todbot/TrinketTouringMachine/README.md

# Trinket Touring Machine

Eurorack module based around Trinket M0

Initially started as an homage to Music Thing Modular's "Turing Machine" module, but as evolved into something more like an algorithmic melody generator.

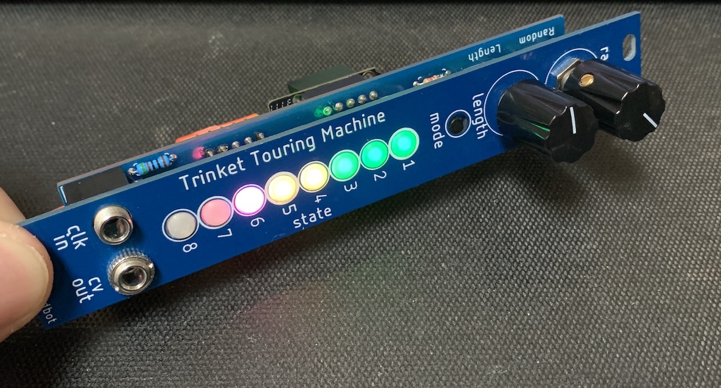
[picture p1: docs/trinkettouringmachine.jpg]
