todbot/TrinketTouringMachine/hardware/TrinketTrigger.brd

## EAGLE design hardware/TrinketTrigger.brd (2020-05-09)

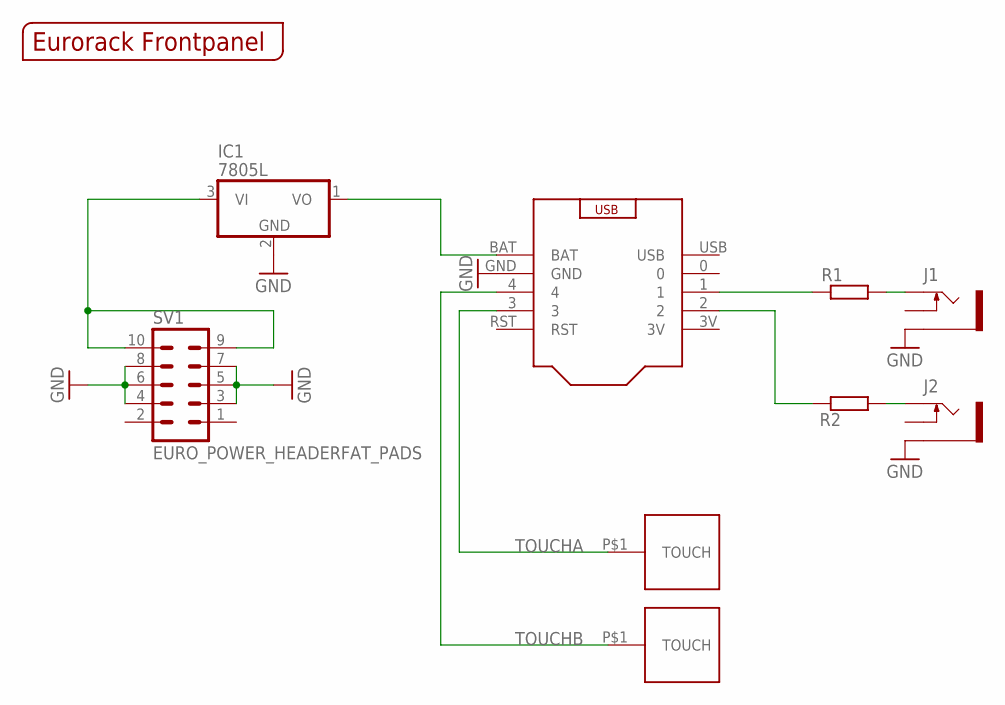
[picture p2: schematic TrinketTrigger.sch]

Parts:
IC1: 7805L; TO92
J1, J2: THONKICONNNEW; WQP-PJ301M-12_JACK
R1, R2: R-EU_0204/5; 0204/5
SV1: EURO_POWER_HEADERFAT_PADS; EURO_PWR_HEADER_FAT
U$1: EURORACK_PANEL6HP; EURORACK6HPPANEL
U$2: TRINKETM0NH; TRINKETMO_NOHOLES
U$3, U$4: TOUCHPADA

Connections:
GND: IC1.2 (GND), J1.P$3_SLEEVE (SLEEVE), J2.P$3_SLEEVE (SLEEVE), SV1.3, SV1.4, SV1.5, SV1.6, SV1.7, SV1.8, U$2.GND
unnamed: J1.P$1_TIP (TIP), R1.2
unnamed: J2.P$1_TIP (TIP), R2.2
unnamed: IC1.1 (VO), U$2.BAT
unnamed: IC1.3 (VI), SV1.9, SV1.10
unnamed: R1.1, U$2.1
unnamed: R2.1, U$2.2
TOUCHA: U$2.3, U$3.P$1
TOUCHB: U$2.4, U$4.P$1

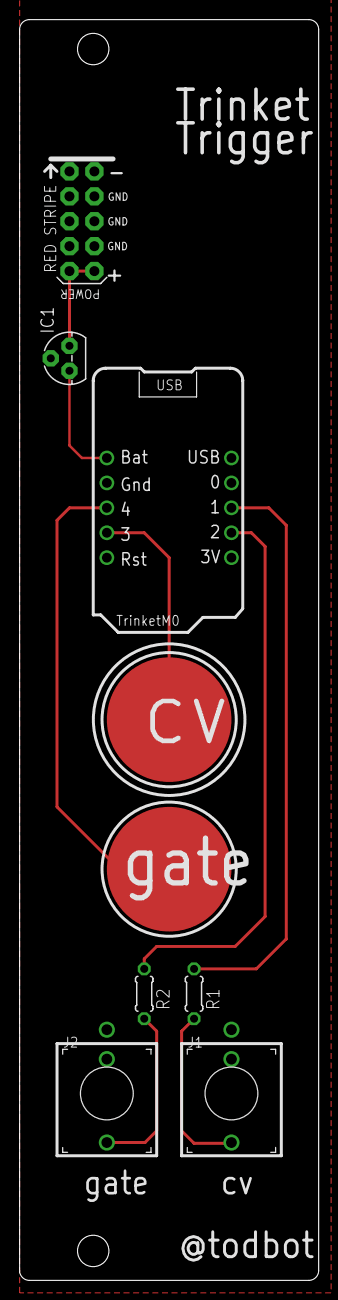
[picture p3: board TrinketTrigger.brd from above]

Board: 2 copper layers, 30.5 x 128.5 mm, 10 parts (0 on the bottom side), 9 nets.
