todbot/TrinketTouringMachine/hardware/touringmach3.brd

## EAGLE design hardware/touringmach3.brd (2019-09-17)

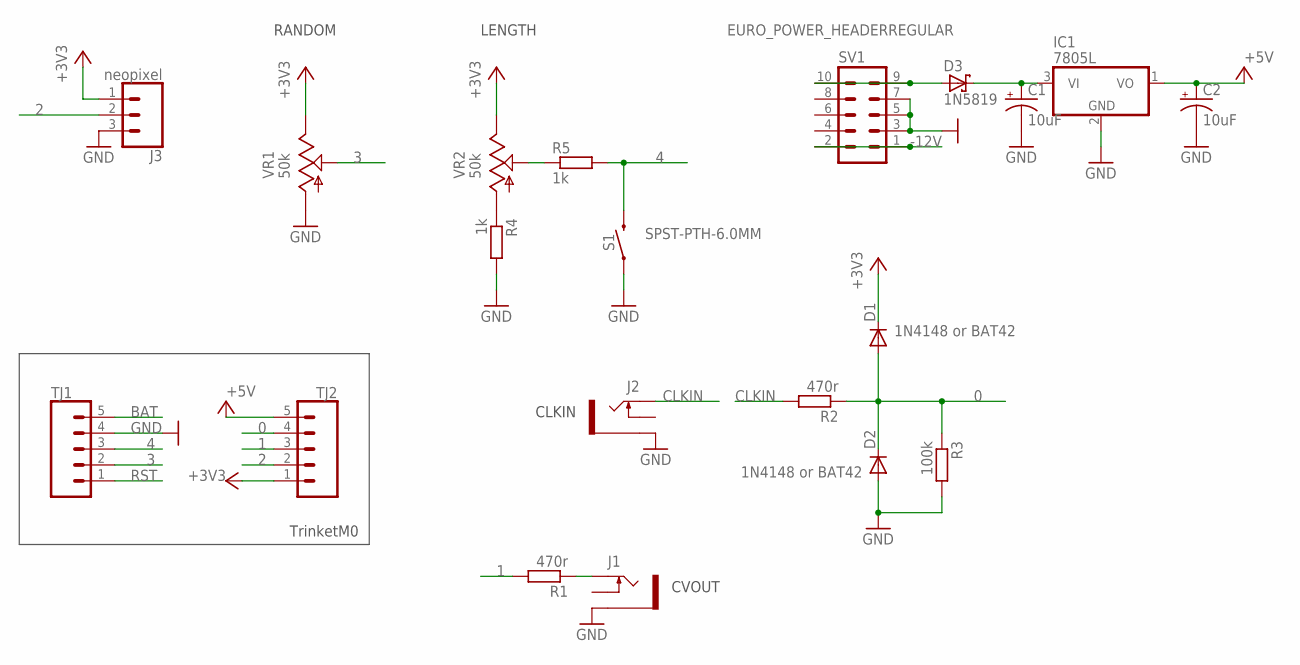
[picture p4: schematic touringmach3.sch]

Parts:
C1, C2: 10uF; E2,5-6
D1, D2: 1N4148 or BAT42; DO34-7
D3: 1N5819; DO41-7.6
IC1: 7805L; TO92
J1, J2: THONKICONNOLD; THONKICONN
J3: neopixel; 1X03
R1, R2: 470r; 7MM_RESISTOR
R3: 100k; 7MM_RESISTOR
R4, R5: 1k; 7MM_RESISTOR
S1: SPST-PTH-6.0MM; TACTILE_SWITCH_PTH_6.0MM
SV1: EURO_POWER_HEADERREGULAR; EURO_POWER_HEADER
TJ1, TJ2: CONN_05; 1X05
VR1, VR2: 50k; 9MM_SNAP-IN_POT

Connections:
0: D1.A, D2.C, R2.1, R3.1, TJ2.4
1: R1.2, TJ2.3
2: J3.2, TJ2.2
3: TJ1.2, VR1.2 (S)
4: R5.2, S1.3 (2), TJ1.3
+3V3: D1.C, J3.1, TJ2.1, VR1.3 (E), VR2.3 (E)
+5V: C2.+, IC1.1 (VO), TJ2.5
-12V: SV1.1, SV1.2
BAT: TJ1.5
CLKIN: J2.P$3_TIP (TIP), R2.2
GND: C1.-, C2.-, D2.A, IC1.2 (GND), J1.P$1_SLEEVE (SLEEVE), J2.P$1_SLEEVE (SLEEVE), J3.3, R3.2, R4.2, S1.1, SV1.3, SV1.5, SV1.7, TJ1.4, VR1.1 (A)
unnamed: J1.P$3_TIP (TIP), R1.1
unnamed: C1.+, D3.C, IC1.3 (VI)
unnamed: D3.A, SV1.9, SV1.10
unnamed: R4.1, VR2.1 (A)
unnamed: R5.1, VR2.2 (S)
RST: TJ1.1

Notes on the sheet:
TrinketM0
CVOUT
CLKIN
RANDOM
LENGTH

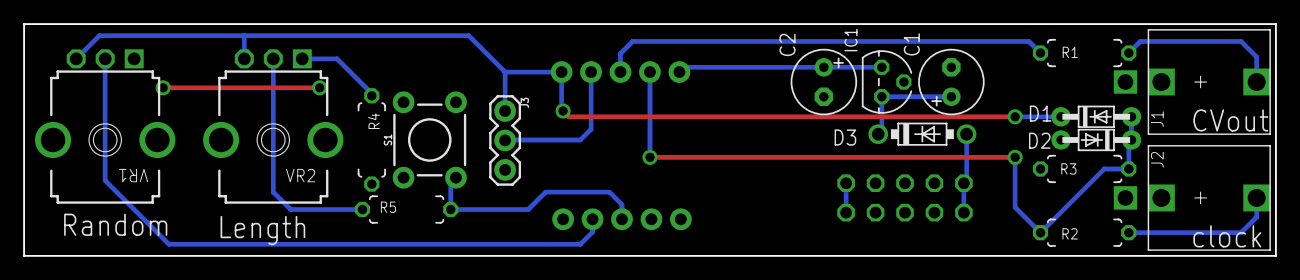
[picture p5: board touringmach3.brd from above]

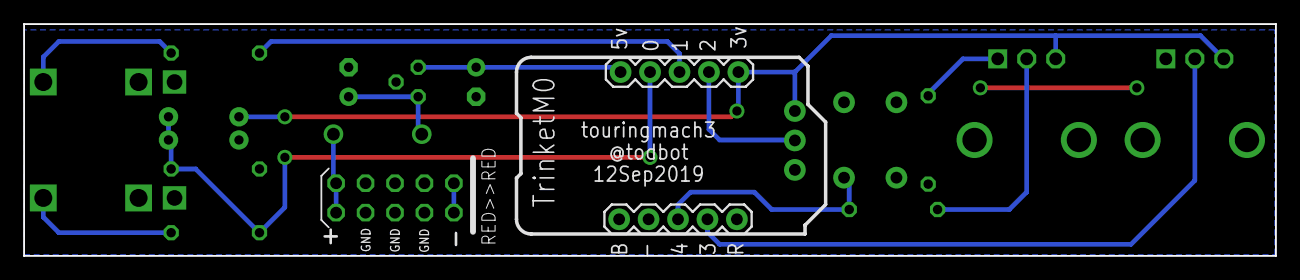
[picture p6: board touringmach3.brd from below]

Board: 2 copper layers, 108.0 x 20.0 mm, 20 parts (3 on the bottom side), 15 nets.
