todbot/TrinketTouringMachine/firmware/pot-button-trinket-test/pot-button-test-schematic.png

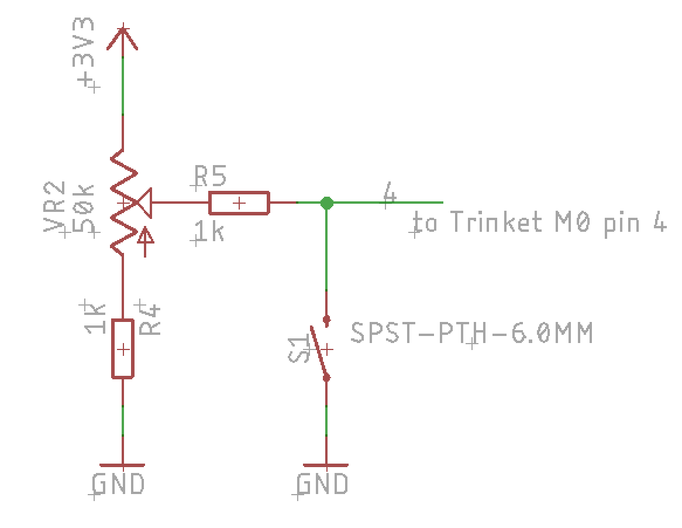
firmware/pot-button-trinket-test/pot-button-test-schematic.png
