todbot/TrinketTouringMachine/(commit log)

2019-09-12 fix formatting
    [touringmach3_frontpanel.brd]
2019-09-15 more progress
    [touringmach3_frontpanel.brd]
2019-09-15 first cut at clock detection
2019-09-17 fix latest sketch
    [touringmach3.brd]
2020-05-09 added TrinketTrigger
    [TrinketTrigger.brd, TrinketTrigger.sch]
2020-08-21 added circuitpython veresion of some ideas
